botanicfields/BF-018A/BF-018a_DOC.pdf

BF-018A.doc V05

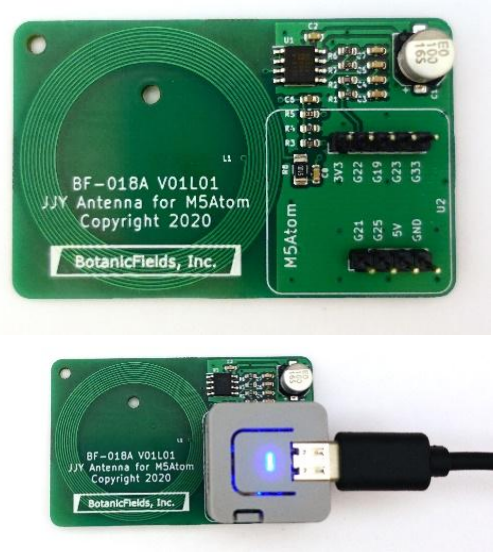
[picture p6: figure]
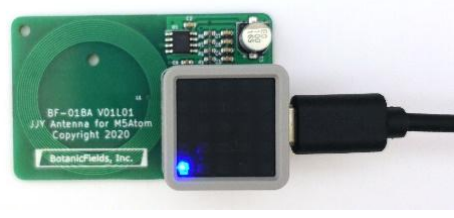
[picture p7: figure]

Copyright 2026 BotanicFields, Inc.

# JJY Antenna for M5Atom

電波時計のための標準電波（JJY）を疑似的に送信

1. はじめに
このプリント基板は、疑似的な標準電波（JJY）を送信するためのアン テナです。電波が届かないところにある電波時計の時刻を合わせます。
2. 使用環境
✓ | ATOMS3 Lite, または ATOM Lite, ATOM Matrix が別途必要です。
| （M5Atom と総称します。）
✓ | サンプルプログラムは GitHub にあります。
✓ | プログラムの書き込みに Arduino-IDE の動作する PC が必要です。
✓ | プログラム書き込み後 PC は不要です。USB-C から電源を供給します。
✓ | Wi-Fi でインターネットに常時接続する必要があります。
✓ | 時刻合わせには、電波時計に依存して 3～5 分程度かかります。
3. 最新情報
| 本説明書の内容は古くなります。最新情報は以下を参照ください。
| GitHub: botanicfields/BF-018A https://github.com/botanicfields/BF-018A
4. 使用方法
(1) M5Atom の取り付け
| プリント基板上のピンヘッダに M5Atom を取り付けます。正しい取り付けを目視で確認してか
ら電源を接続するのが安全です。
(2) Arduino IDE の準備
| M5Atom 用の Arduino-IDE の設定方法は、 M5Stack 社の Web 情報を参照ください。
| 「Arduino 開発環境の構築」https://docs.m5stack.com/ja/arduino/arduino_ide
| ライブラリマネージャで以下のライブラリをインストールしておく必要があります。
| M5Unified, M5GFX, FastLED by Daniel Garcia, WiFiManager by tzapu
| Arduino-IDE, ボードマネージャ、ライブラリの最新版数では、仕様変更等によりコンパイルが
できなかったり正常動作しない場合があります。これらの場合は、大変申し訳ありませんが、「3. 最新情報」にある確認済の版数に合わせ込んでくださいます様、お願いいたします。

(3) M5Atom へのプログラムの書き込み
ATOM S3 Lite では、「3. 最新情報」のサイトにある BF-018ARev4 フォルダおよびフォルダ内 の全ファイルを PC にダウンロードして BF-018Arev4.ino をコンパイルし、書き込みます。 ATOM Lite, ATOM Matrix では、BF-018ARev3 をお使いください。BF-018ARev3.ino をコンパ イルして書き込みます。
(4) Wi-Fi の設定
プログラムの書き込み、リセット、または電源オンで動作を開始すると、まず Wi-Fi 設定が動作 します。Wi-Fi 設定は WiFiManager で行います。詳細は WiFiManager の説明を参照ください。 https://github.com/tzapu/WiFiManager

大まかな流れ:
① M5Atom が、まずは前回接続したアクセスポイントに接続を試みる
② 接続できない場合、M5Atom 自身がアクセスポイントとなりスマートホン等からの接続を待つ
i. スマートホン等で、アクセスポイントとなった M5Atom に接続する ※ SSID: Chip ID に基づく名前、password/key: なし ii. ブラウザで IP アドレス 192.168.4.1 を開く
iii. M5Atom が接続すべき SSID/key を入力する ③ M5Atom が指定された SSID/key で Wi-Fi に接続する
(5) 疑似 JJY 信号の送信
Wi-Fi 接続後、NTP で日付・時刻の取得が完了すると、LED が点滅を開始します。プリント基 板の渦巻きパターン（アンテナ）の平面を電波時計に向けて 30cm 以内のところに置きます。電波 時計を操作して受信を開始すると 5 分程度かかって日付・時刻合わせが完了します。完了しない場 合は、プリント基板の位置や向きを変えてみます。電波時計に内蔵されているバーアンテナの長手 方向の延長線上に置くのがよいです。プリント基板が送出する磁界の方向をバーアンテナの長手方 向と一致させ、プリント基板の渦巻きパターンとバーアンテナのコイルを平行にします。条件が良 ければ 70cm 程度の距離でも時刻合わせができます。 電波時計内のバーアンテナの長手方向の延長線上に置いた動作例: 距離 70cm YouTube: BF-018A: JJY Antenna for M5Atom https://youtu.be/4Soobp9k9r0
(6) LED モニター表示
JJY 信号がオンの間 LED が点灯します。ボタンを押すと、LED モニター表示のオン・オフが切 り替わります。ATOM Matrix の場合、0 番の LED のみを使用します。
(7) シリアルモニター
起動、Wi-Fi 接続、NTP 同期、疑似 JJY 信号生成中などのログ情報をシリアルモニターに出力し ます。トラブル調査に役立ちます。シリアルモニターは必須ではありません。

(8) 動作ログ
動作中のログの例です。

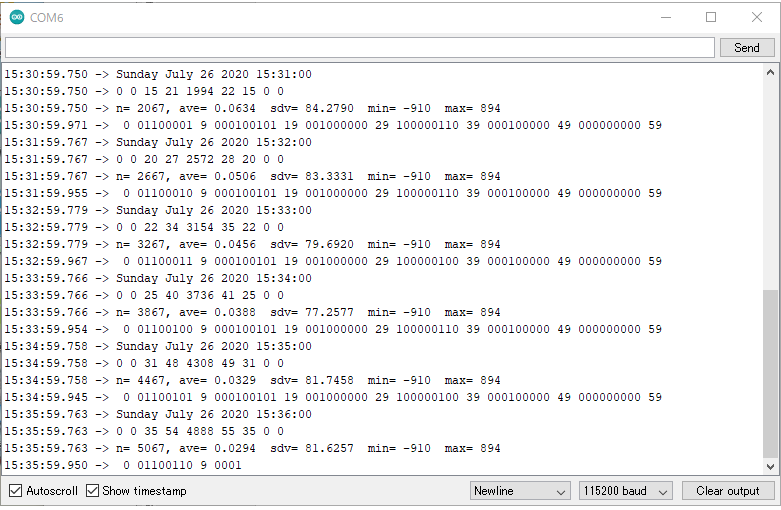
[picture p8: figure]

15:30.59.750 ->
- 現在時刻・日付
- Ticker 周期のずれの分布（出現回数）: 左から ～ -50ms、
-50ms ～ -5ms、
-5ms ～ -0.5ms、
-0.5ms ～ -0.05ms、
-0.05ms ～ 0.05ms、
0.05ms ～ | 0.5ms、
0.5ms ～ | 5ms、
5ms ～ | 50ms、
50ms ～
- Ticker 周期の計測回数、平均（µs）、標準偏差（µs）、最小値（µs）、最大値（µs）

15:27:32.971 ->
送出した JJY 信号
最初の 0、19、29、39、49、59: マーカー マーカー以外: ０，１

(9) Wi-Fi 接続設定の消去
リセット直後にボタンを押したままにすると、M5Atom 内に保存されている Wi-Fi 接続情報を消 去できます。M5Atom は Wi-Fi 接続先の入力待ちになります。
(10) RTC
GROVE ポートに Unit-RTC を接続できます。Wi-Fi 経由でインターネットに接続している通常 の環境では必要ありません。電源オンまたはリセット時において Wi-Fi が繋がらない場合に RTC が保持している日時で JJY 信号を発信できます。インターネットに接続している間、NTP に同期し た日時に RTC をアップデートします。

資料
GitHub: botanicfields/BF-018A https://github.com/botanicfields/BF-018A

Qiita: 標準電波 JJY もどきを M5StickC / M5Atom の Ticker で生成する https://qiita.com/BotanicFields/items/a78c80f947388caf0d36

連絡先
BotanicFields, Inc.
https://www.facebook.com/botanicfields/https://x.com/botanicfields

V01 2020 年 10 月 26 日
V02 2021 年 5 月 29 日「4. (2)M5Atom 用 Arduino IDE の準備」をアップデート V03 2022 年 12 月 3 日「BF-018ARev2」を反映
V04 2024 年 3 月 12 日「BF-018ARev3」を反映
V05 2026 年 4 月 9 日「BF-018ARev4」を反映
