botanicfields/BF-018A/BF-018A_back.JPG

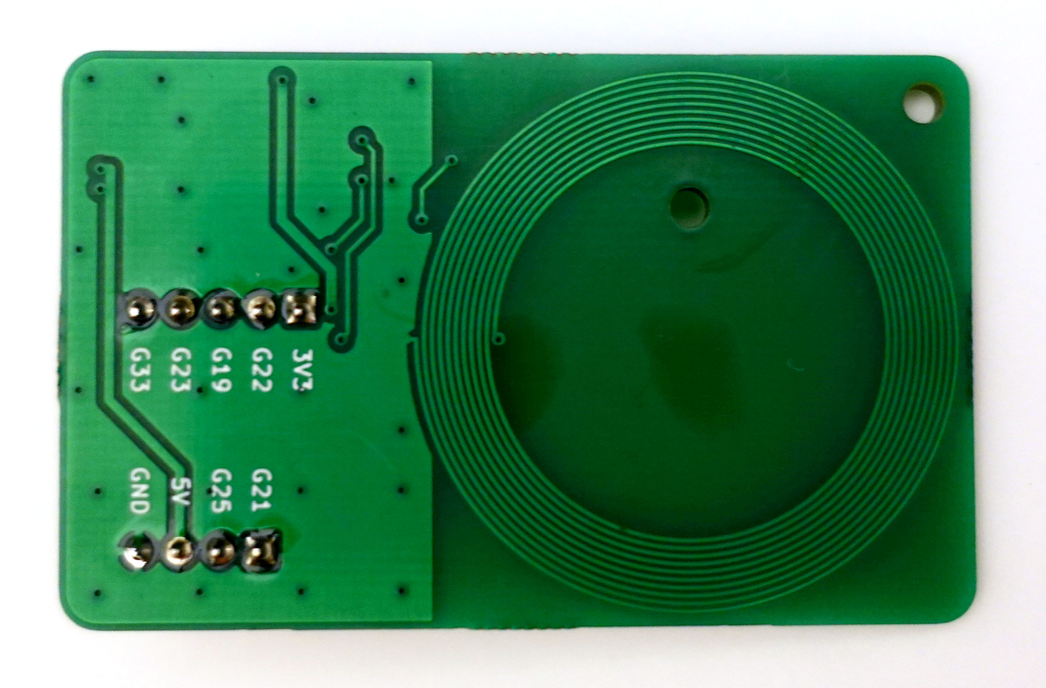
BF-018A_back.JPG
