botanicfields/BF-018A/wifi_ntp_rtc.jpg

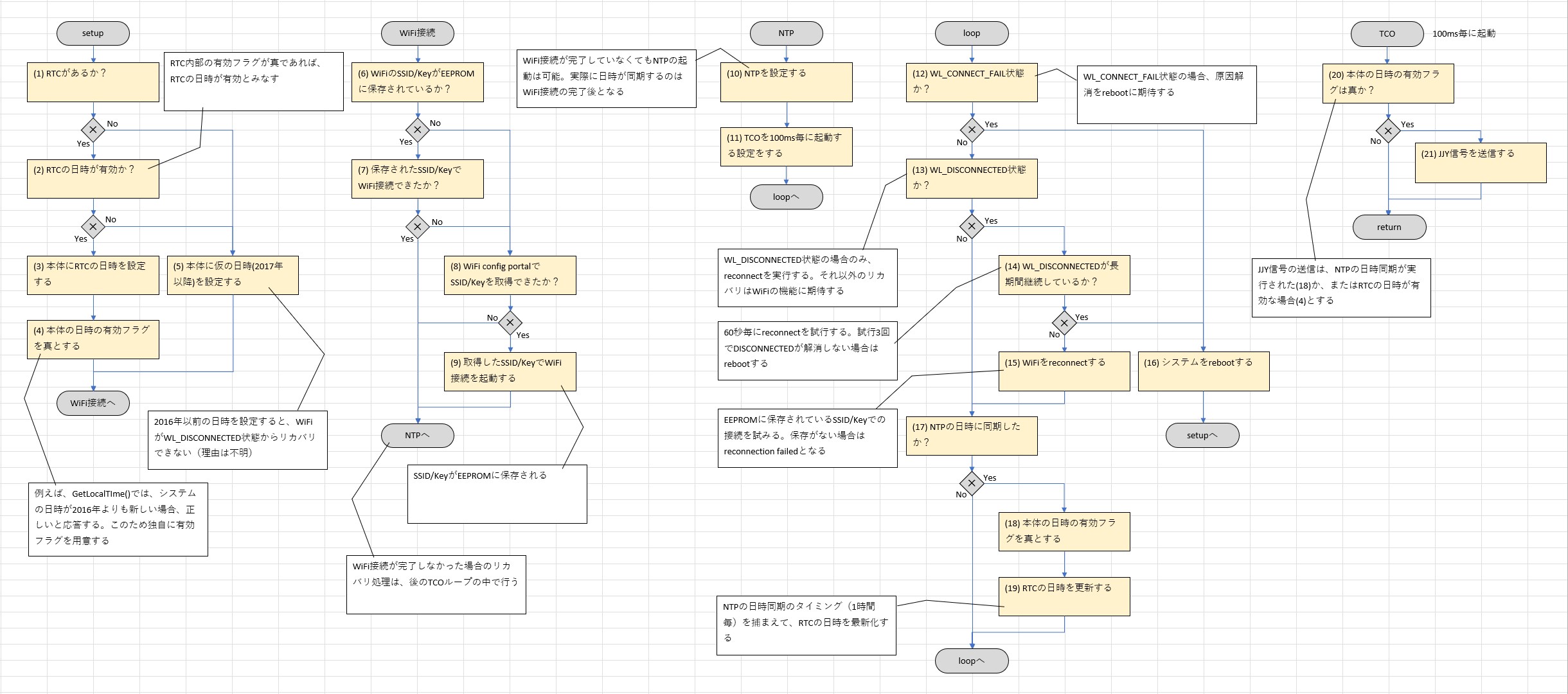
wifi_ntp_rtc.jpg
