botanicfields/BF-018A/PCBV01L02/gerber/JLCPCB/bf-018a_bom.csv

Comment | Designator | Footprint | LCSC
100u | C1 | Capacitor_SMD:CP_Elec_6.3x7.7 | C176674
100n | C2,C8 | Capacitor_SMD:C_0603_1608Metric | C14663
10n | C3,C4,C5,C7 | Capacitor_SMD:C_0603_1608Metric | C57112
10u | C6 | Capacitor_SMD:C_0603_1608Metric | C19702
1k | R1,R2 | Resistor_SMD:R_0603_1608Metric | C21190
51k | R3,R4,R6 | Resistor_SMD:R_0603_1608Metric | C23196
10k | R5,R7 | Resistor_SMD:R_0603_1608Metric | C25804
510 | R8 | Resistor_SMD:R_1206_3216Metric | C17991
MCP6022 | U1 | Package_SO:SOP-8_3.9x4.9mm_P1.27mm | C57639
