botanicfields/BF-018A/(threads)

Thread 1 (2022-01-26):

The Citizen Watch Cannot Work With This

SeanChangX, 2022-01-26:
Hey, I like your project. And I wanna build one myself to my Citizen Radio Controlled Watch, but it seems that nothing gonna happen. So I wonder is there anything that can improve the signal? Or some tricks?

uehara00, 2022-01-26:
Would you please give me additional information?
(1) Are you using the "JJY antenna PCB"?
(2) Does the serial monitor show that the M5Atom is working well?
(3) What is the model number of Citizen Watch?

SeanChangX, 2022-01-26:
1. No. I just use the 1m wire and a 1kΩ resistance
2. Yes. And it continuously shows up the lastest time.
3.  CB5835-83E
https://www.citizenwatch.com.tw/productDetail.asp?sn=785
I wish that would be also work without the PCB temporarily.

uehara00, 2022-01-26:
How nice watch you have!
(1) Make sure that a 1m wire with a 1kΩ resistance is connected between the GPIO22 and the GND of the M5Atom. Since the watch receives the magnetic field of radio waves, the current flowing through the antenna is important.
An example of M5StickC is shown below.
https://www.hackster.io/botanicfields/generate-standard-radio-wave-jjy-with-ticker-of-m5stickc-0330e0

(3)
I searched FAQ in Japanese:
https://citizen.jp/faq/detail/id1275
Questions
How does a multi-station radio clock display the local time?
Answer
When you select a city, the time of that city is displayed and the station to receive is automatically selected.

It is my understanding, that the watch have to be set to city Tokyo because the program of BF-018A simulates the JJY signal in Japan.

I also found the manual.
https://www.citizenwatch-global.com/support/pdf/e660/e.pdf
https://www.citizenwatch-global.com/support/pdf-guide/e660/e.pdf
On page 49, it is said that, the watch receives the time signal every night, so please test over night in Tokyo time.
On page 29, it is said that, it may take 2 - 15 minutes to receive time signal, so please be patient when receiving the time signal  manually.

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

SeanChangX, 2022-01-27:
Yeah, you are right. After doing some tests with the emulator app, I think that was because the time zone(+8) that I choose was only matched with the BPC signal.
So maybe I need to figure out how to generate the BPC signal instead of the JJY.

uehara00, 2022-01-27:
Thank you for verifying the cause. I would like to close this issue.

Closed 2022-01-27.

Thread 2 (2024-12-24):

信号処理のPCBの設計方法を教えてください。

changxinchang, 2024-12-24:
設計したPCB回路の中で、抵抗、コンデンサの数値がどのように設計されているか教えてください。 似たような回路を設計しますが、どのように設計するかわかりません。 詳細な設計プロセスを示してもらえますか？ ありがとうございました。

uehara00, 2024-12-25:
例えばパルス波形を正弦波に近づけるためのローパスフィルタの回路定数は数式で求められますが、最終的にはオシロスコープで波形を観測して修正し、さらに入手しやすい値にしています。
https://www.digikey.com/en/resources/conversion-calculators/conversion-calculator-low-pass-and-high-pass-filter

changxinchang, 2024-12-27:
ご設計のPCBを例にとると、入力信号は40KHZで、ローパスフィルタの周波数は15.9KHZです。どのようにしてこの周波数を決定しますか。 そしてPRSSの周波数、inputの周波数、feedbackの周波数、outputの周波数はどのように決められますか？

uehara00, 2024-12-28:
先日説明しましたとおり、ローパスフィルタの回路定数は、オシロスコープで波形を観測して修正し、さらに部品の入手しやすい値にした結果、結果的に15.9kHzとなる容量値や抵抗値になっています。
PRSSとは何でしょうか？

changxinchang, 2024-12-28:
ローパスフィルタの設計は、まず大まかな値の抵抗とコンデンサを選定し、オシロスコープの波形を観察し、抵抗とコンデンサの値を絶えず調整することで波形を正弦波にするのか？
PRSSはあなたの文章の画像の中です
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

uehara00, 2024-12-28:
抵抗値やコンデンサの値を変化させながらオシロスコープで観測するのは大変です。抵抗値やコンデンサの値を適当に選んで、オシロスコープで波形観測してみる。これを妥協できるところまで繰り返します。
PRSSではなく、PSRR(Power Supply Rejection Ratio)です。PSRR, Input, Outputは、いずれもDCをカットするものです。通過可能な周波数が目的とする信号40kHzに対して十分低いことを確認します。

changxinchang, 2024-12-29:
私はgithubで6局の電波を発生できるシミュレータのプログラムを見つけて、あなたのプログラムと比較して、BPC信号を発生するエラーの場所を修正しました。 しかし、出力された波形は期待どおりにはなりません。
プロジェクト:https://github.com/TaroHs/nisejjy/tree/masterプロジェクト:https://github.com/TaroHs/nisejjy/tree/master
BluetoothSerialの関連コードを削除しました。BPCコードのエラーは、wdayの処理方法です。 あなたのプログラムによると、元のコードの587の後に追加しました
if（nowtm.TM_wday==0）bits60[8] = 1；
if（nowtm.TM_wday==0）bits60[9] = 3；
これで、プログラムの実行結果はあなたのプログラムと一致します。

changxinchang, 2024-12-30:
ご協力ありがとうございます。 あと何回かテストして、出力された波形が期待どおりにならなければ、このプロジェクトを断念します。 ご協力ありがとうございました。 ありがとうございます。

changxinchang, 2025-01-01:
何度もデバッグした後も、生成された電波信号は電波時計に正常に時刻合わせできない。 プログラム出力の数値は正常で、出力波形も正常ですが、なかなかうまく動作しません。 この6局の電波シミュレータのプロジェクトを断念する。 ご協力ありがとうございます。 ありがとうございます。

uehara00, 2025-01-01:
デバッグを諦めるとのことを了解しました。このイシューはクローズします。

Closed 2025-01-01.

Thread 3 (2025-03-18):

PCB JJY antenna

scope41, 2025-03-18:
Hi, will the JJY antenna PCB works on BPC?

scope41, 2025-03-19:
Thank you for your fast response. I am ordering the JLCPCB for the first time.
After uploading the gerber file, the default "Delivery Format" is "Single PCB".
And after uploading the "bf-018a_panel2-top-pos.csv", I got a prompt for "Duplicate Designators Detected"

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

Should I proceed with the order or did I missed out something?

uehara00, 2025-03-19:
The gerber files includes 2 PCBs panelized, and must be set "Panel by Customer".

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

The BOM and place files are "Complete file", so please select it not default.
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

scope41, 2025-03-19:
Thank you very much for the awesome project. Keep it up.

Closed 2025-03-19.
