botanicfields/BF-018A/bf-018a_scm_v01l02.pdf

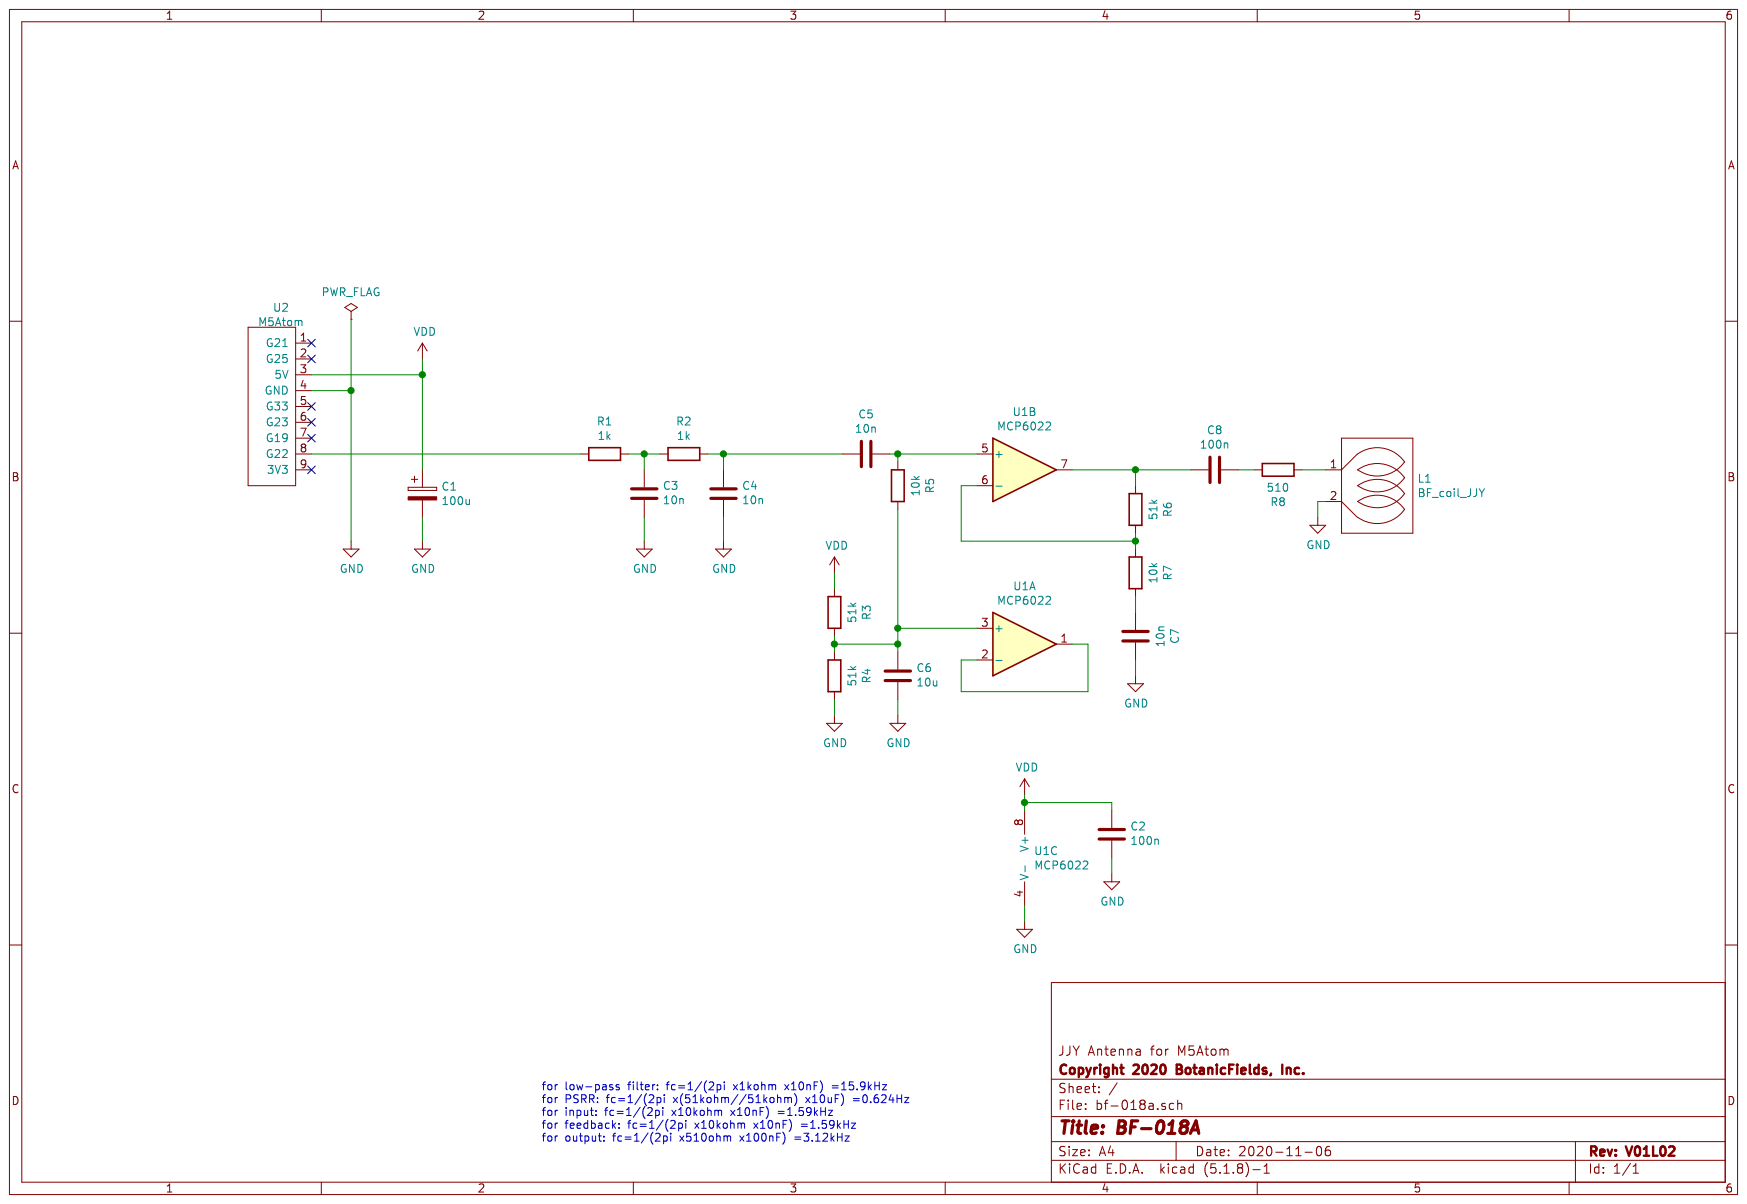
[picture p11: page 1]
