botanicfields/BF-018A/bf-018a_scm.pdf

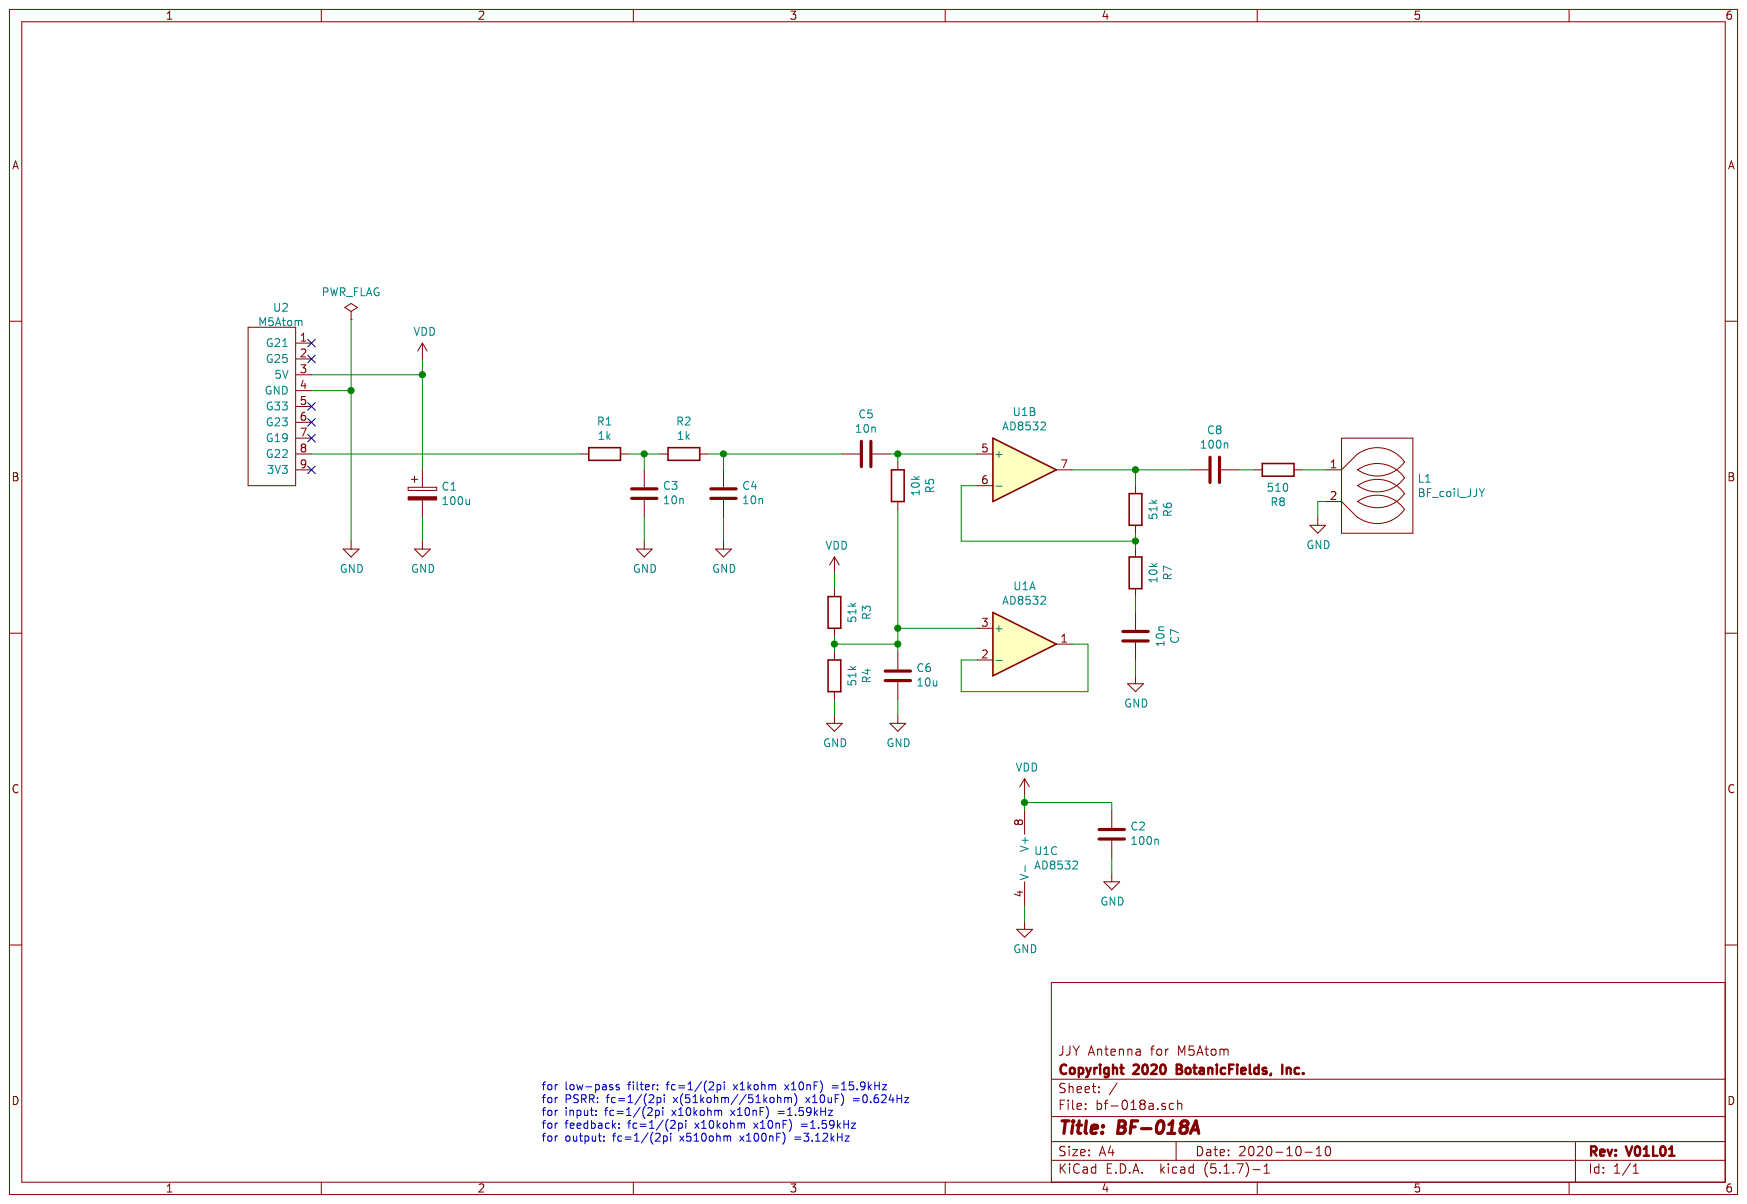
[picture p12: page 1]
