botanicfields/BF-018A/(commit log)

2020-10-24 Update BF-018A.ino
    change LED-B/G color level
2021-05-17 Update BF-018A.ino
    Corrected leap year calculation: Wrong date in multiples of 400 years and January-February
    [BF-018A.ino]
2021-05-29 Update BF-018a_DOC.pdf
    updated description to set up Arduino IDE for M5Atom
2021-06-30 gerber
    add gerber
    [bf-018a_bom.csv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]
2022-03-05 Update README.md
    IDE, boards, library revisions
2022-08-18 Rev2
    WiFi recovery, LED, RTC
    [wifi_ntp_rtc.xlsx]
2022-08-19 Update README.md
    GROVE cable length
2023-04-27 BF-018ARev.2.ino
    Fixed PWM parameters
    [BF-018ARev2.ino]
2023-10-18 Update README.md
    IDE, Board, library Environments
2024-03-12 Update README.md
    ボタン
